casiomichael/Integrated-Design-Challenge/README.md

# Integrated-Design-Challenge
The Integrated Design Challenge was a project for ECE110 at Duke in which students designed, constructed, and programmed an Arduino robot that can autonomously move, perform tasks (in this case, read RFID tags), and communicate via XBee with other robots to accomplish a Star-Wars Themed task.

- In this repository, the code for my group (the Orange Squadron), is included, as well as the overall project task, and other groups' individual tasks. 
- Additionally, in this repository are deliverables submitted throughout the semester, including a GANTT chart, a cost estimate, and a final report detailing the entirety of the project (i.e. process of design, construction, coding, circuit wiring, etc.)
