casiomichael/Integrated-Design-Challenge/Cost Estimate.pdf

Description | Quantity | Price ($) | Total ($)
Red LED | 1 | 0.32 | 0.32
Green LED | 1 | 0.32 | 0.32
Yellow LED | 1 | 0.32 | 0.32
10 kOhm ¼ W Resistor | 2 | 0.10 | 0.20
Wire, 22 AWG, solid 100 ft, Blk ($0.08/ft) | 1 | 7.95 | 7.95
3 pin m/m header | 5 | 0.5 0 | 2.50
3/8 ” 4 -40 pin -head screws | 5 | 0.02 | 0.10
BOE Shield for Arduino | 1 | 34.99 | 34.99
Arduino ATMEGA 2560 | 1 | 51.91 | 51.91
USB A to B Cable | 1 | 4.99 | 4.99
7/8 ” 4 -40 pin -head screws | 4 | 0.03 | 0.12
1/4 ” 4 -40 pin -head screws | 15 | 0.01 | 0.15
½” round spacers | 3 | 1.30 | 3.90
Nylon washers | 3 | 0.07 | 0.21
4 -40 pin zinc -pl ated nut | 20 | 0.01 | 0.20
BOE -Bot Li Ion Power Pack w/ cable and barrel plug | 1 | 49.99 | 49.99
Continuous rotation servomotor | 2 | 13.99 | 27.98
1 ” round standoffs | 7 | 1.33 | 9.31
Xbee Module | 1 | 22.99 | 22.99
BOE -Bot 1 ” tail ball wheel | 1 | 3.95 | 3.95
BOE -Bot plastic wheel w/ tire | 2 | 3.99 | 7.98
BOE -Bot aluminum chassis | 1 | 24.99 | 24.99
QTI Sensor | 5 | 9.99 | 49.95
2x16 Serial LCD | 1 | 29.99 | 29.99
Total | | | 335.31
